JoseRicardoR/Resafeve/README.md

# Resafeve
Proyecto final de Sistemas Embebidos Universidad Nacional de Colombia

**Toda la información de este proyecto se encuentra en el repositorio de github: https://github.com/esteban11519/SistemasEmbebidos**

Integrantes del grupo:
*Mateo Bernal Bonil - Valentine Chimezie Muodum Prieto - Esteban Ladino Fajardo - Jose Ricardo Rincón Peláez*

Se quiere hacer un sistema de monitoreo en reservas naturales para reservas naturales, en el cual se instalan microfonos en arboles para el regustro de audio y su procesamiento con IA en un servidor aparte. Los micrfonos se controlan con ESP32, la comunicación se plantea por medio de MQTT al servidor Mosquitto situado en una Raspberry, conectada tambien a un servidor online.
En el siguiente esquema se ve la logica de funcionamiento, aunque en nuestro caso se hace uso de un servidor Mosquito, y el sensor es un microfono. Además si bien se pueden recibir mensajes con el ESP32 (y además se implemento dicha función) no fue necesario una aplicación que usara ese camino.

Esquema general

Luego, la inteligencia artificial usada se encuentra en: https://github.com/IBM/MAX-Audio-Classifier . Además la ESP32 deberá correr un sistema operativo en tiempo real para su mejor rendimiento, en este caso se usa FreeRTOS.

El proceso planteado es el siguiente:
* Registrar alrededor de 10 segundos en un arreglo de bytes en el ESP32.
* Enviar la señal en bytes desde el ESP32 hasta la raspberry por medio de mqtt.
* Luego en la raspberry convertir los datos en bytes en un archivo de audio .wav.
* Procesar con la IA el archivo de audio y obtener los resultados.
* Guardar los resultados en la en la base de datos InfluxDB.
* Finalmente mostrar los resultados en una pagina web para la toma de decisiones.

En cuanto a este repositorio, el archivo README es una documentación extensa y detallada de lo desarrollado, y se encuentran cuatro carpetas con las partes del proyecto. La carpeta de "DockerServices" contiene todas las aplicaciones de Docker además de las herramientas necesarias, la carpeta "ESP32" contiene todos los archivos relacionados con el microcontrolador, la carpeta "Front_end" la infromación relacionada a la pagina web y la carpeta "Prototipo" la información relacionada con el producto fisico en cuestion.

## Funcionalidad de la ESP32
En la carpeta del "SistemasEmbebidos/ESP32/EjemplosGuia/" se encuentran los siguientes archivos que sirven como base para realizar pruebas sencillas y entender el manejo de las herramientas usadas:
* freeRTOS.ino, que es un codigo desarrollado en arduino para la ESP32 en el que se ejemplifica el uso del FreeRTOS con multiples tareas.
* esp32_Multitasking.ino, que es otro ejemplo del uso de FreeRTOS pero aprovechando los dos cores del ESP32.
* mqtt_ESP32.ino, es un ejemplo de uso de MQTT en el ESP32 para muestrar datos, publicarlos, y recibir información. Como servidor de prueba se usa test.mosquitto.org, que es gratuito y disponible en internet para todo publico.
* I2C_Mic.ino, es el codigo de prueba más sencillo posible el microfono INMP441 con la interfaz I2S en el ESP32.
* python_mqtt_client.py, es un script de python sencillo que recibe y publica mensajes por medio de MQTT. Este fue modificado para que cuando acabara de generar en .wav lo enviara a la inteligencia artificial y publicara los resultados en el tópico cuyo inicio es *Embebidos/* los cuales se guardaban en la base de datos InfluxDB. En última instancia se le cambió el nombre a app.py y se ejecutó en un docker.

El microcontrolador usado en el proyecto es el ESP32 de referencia Wemos Loolin32. Este dispositivo cuenta con dos cores y la posibilidad de conectarse a internet. 

Pin out ESP32

Con el desarrollo del proyecto se evidenciaron y señalaron las limitaciones del dispositivo.

### PubSubClient
Para la comunicación se usa el protocolo de MQTT, que en el caso de la ESP32 se conecta con la librería PubSubClient, y para los demás elementos se usa la líbreria de python paho-mqtt. MQTT usa un sistema de subscripciones para la publiación de mensajes a tópicos específicos en el servidor.

Luego, unas primeras preguntas fueron ¿Cuantos segundos puede grabar el ESP32?¿De que tamaño es el Packete que se enviara?
De acuerdo a la documentación de pubsubclient el paquete máximo que se puede enviar son 256 bytes con la configuración. Es decir, hay un limite en el tamaño de paqute que se puede enviar, más en la propia documentación se explica que con la funcion client.setBufferSize(MQTT_MAX_PACKET_SIZE); se puede elegir el tamaño máximo del Buffer.
Luego la duda es por el lado de que tamaño es limite máximo que podemos tener. La cuestion es que entre más grande el paqute más se depende de la conexión a internet.

### Microfono electret
En primera instancia se probó para el muestreo de audio el uso de un micrófono electret con una configuración de amplifiación ya usada en otros proyectos. Luego el ESP32 en alguno de sus pines de lectura debería de ser capaz de muestrear la señal a la frecuencia deseada con el uso de un while y un delay. El archivo ESP32_Audio_mqtt_electret.ino en la carpeta del proyecto, se muestra el código en cuestion.

Cuando se implemento el codigo se encontró con el primer problema, la lectura de los pines del ESP32 no funcionaba. 
¿Por qué no funciona el AnalogRead en el código?
En cuanto al error de lectura del ESP32 cuando se usa el WiFi y MQTT el problema son que pines se eligen. Tal como indica la documentación y un foro, algunos Pines (como el 13 que se estaba usando) usan registros ADC2 que son los que manejan las funciones de WiFi de forma que si el WiFi esta activado quedan inhabilitados. Los pines que no se pueden usar son:  GPIO0, GPIO2, GPIO4, GPIO12 - GPIO15, GOIO25 - GPIO27. Luego de cambiar a los pines 34 para la lectura esta se hizo posible. 

Con el montaje inicial se desarrollo un script de python (en la carpeta SistemasEmbebidos/ESP32/Proyecto/python_mqtt_client_packages.py ) que recibia la información enviada del ESP32 y usaba multiples librerias. El proceso era:
* Se divide la información en el ESP32 en dos bytes por dato. La lectura es de 12 bits escalada a 16 bits. Pero el canal es de solo un byte de ancho. Además la inteligencia artificial pide idealmente un audio de 10s con una frecuencia de muestreo de 44100Hz y una resolución de 16 bits.
* En python se recibió esta información y con la funcion [numpy.frombuffer](https://numpy.org/doc/stable/reference/generated/numpy.frombuffer.html?highlight=frombuffer#numpy.frombuffer) se llega a la solución ya que retorna un arreglo unidimensional a partir de la señal de entrada 
* En el archivo python se usa luego la función numpy.concatenate para crear una [variable global](https://es.stackoverflow.com/questions/10768/crear-variables-globales-en-python) con toda la información recibida en todos los paquetes.  
* Finalmente se usan variables para contar los paquetes y datos y cuando se llega al punto deseado se usa https://docs.scipy.org/doc/scipy/reference/generated/scipy.io.wavfile.write.html#scipy.io.wavfile.write para crear el .wav

Este proceso funcionaba pero la calidad del sonido era mala y los tiempos de eran mucho más largos de lo esperado (enviar 9 segundos costaba casi minuto y medio). Una alternativa era usar las funciones beginplubish() y endpublish() de PubSubClient para que el proceso fuese más bien un stream de datos. Más sin embargo, estas dos funciones no enviaban toda la información por algún error desconocido. 

La solución inicial fue bajar la frecuencia de muestreo, de 44100Hz a 8000Hz. Antes de ello se probo en la inteligencia artificial que aún con audios de 8000Hz se obtuvieran resultados decentes. En comparación los resultados se muestran a continuación:
```
* 44100 Hz: {"status": "ok", "predictions": [{"label_id": "/m/01j4z9", "label": "Chainsaw", "probability": 0.6540094614028931}, {"label_id": "/m/04_sv", "label": "Motorcycle", "probability": 0.1308945119380951}, {"label_id": "/t/dd00066", "label": "Medium engine (mid frequency)", "probability": 0.12884050607681274}, {"label_id": "/m/0_ksk", "label": "Power tool", "probability": 0.11332365870475769}, {"label_id": "/m/07yv9", "label": "Vehicle", "probability": 0.10684427618980408}]}
```
```
* 8000 Hz: {"status": "ok", "predictions": [{"label_id": "/m/01j4z9", "label": "Chainsaw", "probability": 0.4117594063282013}, {"label_id": "/m/04_sv", "label": "Motorcycle", "probability": 0.206061452627182}, {"label_id": "/m/07yv9", "label": "Vehicle", "probability": 0.1337493658065796}, {"label_id": "/m/0_ksk", "label": "Power tool", "probability": 0.1071915328502655}, {"label_id": "/t/dd00066", "label": "Medium engine (mid frequency)", "probability": 0.07981646060943604}]}
```

Evidentemente con la frecuencia de muestreo mayor son mejores los resultados más con la frecuencia un poco más baja igual funciona.
Esto soluciono el problema del tiempo que ahora en total solo 16 segundos, es decir 2 segundos de envio por paquetes de 3 segundos. Paquetes mayores a 3 segundos con las condiciones descritas llenan la memoria. En términos generales se espera un tamaño de paquete alrededor de 48000 bytes. 
Por otro lado el problema de la calidad del audio seguia existiendo. Se probaron entonces mejores etapas de amplifiación como las mostradas en las imagenes.

Circuitos de amplificación señal de microfono electret

Pese a esto el montaje mostrado en la siguiente figura no tenia una buena calidad de sonido, además de tener una frecuencia de muestreo baja.
Montaje con amplificación y micrfono electret.



En todo caso no se consiguio que la señal de audio fuera mejor, ni añadiendo condensadores de desacople, en su mayoria es ruido como se ve en la siguiente imagen. Por ende el sonido no es legible.

Audio Con microfono electret

Se buscaron entonces alternativas y se encontro una de cambiar el sensor del proyecto.

### Microfono I2S INMP441
Tal parece que la conversión analoga digital del ESP32 consume mucho más CPU de la que se espera y hace que los procesos sean más demorados. Además si bien el circuito de amplificación está bien, se hace necesario el uso de un filtro para limpiar la señal. Se encontro que un micrófono Mems que usa la interfaz I2S se desarrollo para este tipo de proyectos. Su bloque funcional es como se ve a continuación.

INMP441

Luego como ya todo esta incorporado en este micrfono la labor consiste en configurar el software para su buen funcionamiento. Al incio se obtuvo un problema visible en la imagen a continuación. 

Audio con errores

El error consiste en que a veces el audio enviado no se graba correctamente, las muestras no se llenan por completo y hay muchos datos en 00. En consecuencia el audio suena entrecortado y “robótico”. Pese a las múltiples pruebas no he descubierto que genera estas inconsistencias, ni el tamaño ni cantidad de dma, ni los pines, ni el APLL-CLK, ni el tamaño de paquete ni audio total. Sencillamente, a veces funciona y a veces no.

Al revisar el montaje se encuentra que uno de los pines está mal conectado. Si se usa solo la señal mono izquierda es decir, .channel_format = I2S_CHANNEL_FMT_ONLY_LEFT,  se debe conectar el pin L/R a ground obligatoriamente. Dejarlo sin conectar como sugieren algunos tutoriales puede ocasionar el problema encontrado.

El montaje final es como se muestra a continuación. Muy sencillo.



El codigo completo se encuentra en la carpeta del proyecto con el nombre ESP32_I2S_Sampling.ino.
La señal de audio de salida es en definitiva clara y sin interrupciones. Se puede además muestrear a mayores frecuencias, se elige la de 16000Hz para no saturar de datos la red y la memoria del ESP32.



También se cambió el script de python para que ahora solo se requiera la libreria de Pahoo, así pues lo que se hace es generar un header al inicio del archivo que lo hace legible como .wav. Dicho header varia en relación a la frecuencia de muestreo, el numero de bits de resolución y el largo del archivo .wav.

El archivo definitivo tiene el nombre de ESP32_audio_receiver.py, y la explicación del header se puede encontrar en: http://soundfile.sapp.org/doc/WaveFormat/.

### FreeRTOS

En cuanto al componente FreeRTOS del proyecto, como se utiliza solo una función para todo el proceso en el ESP32, se procedio a hacer una tarea que contuviese todos estos elementos. En el archivo ESP32_I2S_Sampling.ino se ve como la tarea i2s_adc es instanciada como una task de FreeRTOS y este se reincia una vez cumple su ciclo. En una implementación donde se quisiese muestrear con dos microfonos al tiempo se podria crear una segunda tarea i2s_adc_2 con la misma funcionalidad. 

### Alimentación
Se analizaron dos alternativas para la alimentación de la ESP32 cuando se probase en campo. La primera y más sencilla es la alimentación de la tareta por medio de una pila de litio CR123 de 3.3V. En este caso se pudo realizar la prueba más parece para la aplicación dada se requiere una mayor potencia pues no fue suficiente para encender el montaje. Luego la segunda opción y mejor elaborada es el uso de paneles solares que carguen una pila de litio. Así será realmente independiente el diseño de estar conectado a una red electrica o de el recambio de baterias. El montaje es como se muestra a continuación y como documenta el proceso en https://randomnerdtutorials.com/power-esp32-esp8266-solar-panels-battery-level-monitoring/.

Alimentación ESP32 con paneles solares

En la carpeta "Prototipo" se muestran imagenes de la PCB con todos los componentes mencionados, así como un imagen 3D de como se vería el montaje completo.

## Funcionalidad de la FPGA

La tarjeta FPGA usada para este proyecto es la Blackice MX. Este dispositivo cuenta con la posibilidad de ser programado mediante un entorno grafico llamado
Icestudio mediante bloques que representan los modulos que normalmente se insatancian al ser usado un lenguaje de descripción de hardware convencional
(Verilog o VHDL).
Blackice II

### Tareas
La tarea principal a realizar por la FPGA en este proyecto consiste en la deteccion de audios validos que puedan ser analizados por medio de una inteligencia artificial,
esto con el fin de no saturarla con muchas peticiones procedentes de varios microfonos. Para que un audio se considere como válido, un porcentaje arbitrario de las
muestras que conforman una grabación (este porcentaje es determinado por el diseñador), deberá superar un umbral de intensidad (tambien establecido por el diseñador),
esto con el fin de determinar que el audio en efecto si puede contener información relevante y no es simplemente silencio o ruido intermitente.

Como ya se mencionó el ESP32 enviará la información referente a la Raspberry por medio de un servidor MQTT. Esta información será enviada a la FPGA por medio de un protocolo
de comunicacion serial (SPI), para su análisis y posterior devolución de resultados. En esta aplicación la Raspberry sera el denominado "Maestro" y la FPGA el "esclavo" debido
a como se realizan las solicitudes y quien es quien necesita enviar los comandos para la correcta operación del módulo.

Maestro_Esclavo

Para esta implementación se hara uso del bloque esclavo presente en una de las librerias de Icestudio.

Bloque_esclavo

Cada muestra de audio es representada por 2 Bytes de datos (16 bits), Sin embargo el bus de datos de este módulo es de 8 bits (que son recibidos serialmente desde el 
maestro y organizados en un registro propio del módulo). Por tanto se asignara 2 posiciones de memoria (2 registros de 8 bits mapeados en derterminadas direcciones de memoria),
a una muestra de audio en un instante. Para el envio de esta señal a la FPGA se cuenta con el bloque "SPI-cmd-regs" que se encargara de primero apuntar a la dirección de
alguno de los registros de la muestra instantanea y luego escribir el dato designado por el maestro, tambien es posible leer este dato en caso de que se requiera hacer alguna comparación (notese que se requerirá hacer dos veces este proceso para llenar totalmente los registros asignados a la muestra). 

### Control por SPI
SPI_Control_Mapeo

### Lectura de muestra


Arriba se puede ver el control de las posiciones de memoria de todos los registros asociados a la FPGA junto al diagrama que hace posible la concatenanción para la creación de
la muestra instantanea.

Una vez cargado el valor de la muestra instantanea, el maestro dará la orden de comparar la muestra con el valor de intensidad umbral previamente establecido, en caso tal de
que la muestra tome un valor mayor al establecido el contador se incrementara, esta orden de comparación tambien incrementara un registro donde se llevara la cuenta de cuantos
datos han sido comparados y por tanto el total de muestras validas que se han leido hasta el momento.

### Bloque de Comparación
Comparacion

### Bloque de Conteo de Muestras


El programa cuenta tambien con una funcion de reseteo universal de registros asignado a una posición de memoria en caso tal de que el maestro por alguna razon quiera abortar o 
reiniciar el proceso

En algunas imagenes se han mostrados bloques cuya unica funcion es leer constantes asociadas a posiciones de memoria especificas y retornar booleanos que son asignados a una variable de control en funcion a si esta constante coreesponde a la posicion de memoria seleccionada en una anterior transaccion, dichos bloques son los encargados de seleccionar el registro desde donde se seleccionara la información que sera enviada en la proxima transaccion de SPI desde el esclavo al maestro.

### Ejemplo de bloque de lectura de comparacion de identificacion de posicion de memoria



Para la lectura de registros se hace uso de un codificador 16-4 junto a un multiplexor 16-1 de 8 bits, la tarea del codificador es cifrar una la posiciones de memoria a la que se apuntó, de manera que este dato cifrado es reconocido como la linea desde la que el multiplexor deberá leer la información asociada a la posicion de memoria y por tanto enviarla por el pin MOSI. En caso de que ningun registro sea seleccionado para lectura, o de que se seleccione uno inexistente, la informacion enviada en la proxima transaccion al SPI será FF.

### Bloque de lectura de registros del esclavo


El mapa de memoria detallado obviando las posiciones asignadas a las instrucciones de apuntado, lectura y escritura se muestra a continuación.
### Mapa de Memoria del esclavo
<ul>
<li> hx01: M16_1  (Byte mas significativo de la muestra) </li>
<li> hx02: M16_2  (Byte menos significativo de la muestra) </li>
<li> hx03: Comparacion  (Emite un pulso que luego debera ser bajado a 0,
este pulso da la orden de comparar la muestra con el umbral y contabilizar) </li>
<li> hx04: U_Reset  (Resetea los contadores, hace la funcion de reset universal) </li>
<li> hx05: CriterioAud (Informa si las muestras que se han analizado superan  
el umbral de audio valido) </li>
<li> hx06: LCompleta (Informa si ya se ha hecho la lectura de todas las muestras) </li>
<li> hx07: Ndato1 (Recoge los 8 bits menos significativos de la cantidad total de 
datos que han sido leidos) </li>
<li> hx08: Ndato2 (Recoge los segundos 8 bits menos significativos de la cantidad
total de datos que han sido leidos) </li>
<li> hx09: Ndato3 (Recoge el bit mas signicado de la cuenta total de datos, este 
bit sera el menos significativo del arreglo de 8 bits que se envia) </li>
<li> hx0A: CUmbral1 (Recoge los 8 bits menos significativos de la cantidad total de 
muestras que han superado el umbral) </li>
<li> hx0B: CUmbral2 (Recoge los segundos 8 bits menos significativos de la cantidad
total de muestras que han superado el umbral) </li>
<li> hx0C: CUmbral3 (Recoge el bit mas significativo de la cantidad total de 
muestras que han superado el umbral,este bit sera el menos significativo del 
arreglo de 8 bits que se envia) </li>
</ul>

El diagrama total de la implementación de las funciones de comunicación (apuntado, lectura y escritura), y del esclavo (comparación, conteo, etc) se muestra a continuación.

### Diagrama de Implemantacion en la FPGA


Se adjunta a la documentación un archivo .ino haciendo las veces de maestro donde se puede verificar algunas de las funciones implementadas en la FPGA 
## Funcionalidad DockerServicios

Se encuentra implementado para la arquitectura ARMv7 y para AMD hasta antes de la integración total con el ESP32. En general los siquientes comandos se usan para ambas arquitecturas:

* Hacer una imagen (no olvidar estar en el directorio del Dockerfile y el punto al final):
```bash
sudo docker build -t <nombre_imagen>:tag . 
```
* Para montar servicios desde docker compose (se debe estar en el directorio del archivo *docker-compose.yml*):
```bash
sudo docker-compose up -d 
```

* Ver servicios montados:

```bash
sudo docker ps 
```

* Para reiniciar los servicios de docker compose (útil cuando se hace algún cambio en volúmenes y se debe estar en el mismo directorio del archivo docker-compose.yml).

```bash
sudo docker-compose restart 
```

* Para parar y eliminar los servicios de docker compose:
```bash
sudo docker-compose down 
```
* Para mirar las imágenes creadas:
```bash
sudo docker images
```

* Para eliminarlas:
```bash
sudo rmi <id/name>
```

Se eligió montar todos los servicios en contenedores docker dada la portabilidad.
### Servicios implementados en Docker

Se tomaron los mismos servicios que Sánchez [Sanchez] y las mismas configuraciones con algunas excepciones que se van a explicar.

#### Docker-compose

En el curso introductorio del youtuber [Pelado Nerd](https://www.youtube.com/watch?v=CV_Uf3Dq-EU) sobre docker se comenzó a montar contenedores desde comandos básicos hasta el punto de usar docker compose. Docke-compose hace parte de docker y su principal ventaja radica en organizar los volúmenes, las dependecias, los puertos y demás cosas en un archivo con el nombre *docker-compose.yml* de manera organizada. Sin embargo, la principal característica es que se crea por defecto una red entre los sevicios y el nombre de cada servicio tiene el alias de la ip de cada contenedor. Por ejemplo, en la siguiente sección de *docker-compose.yml* el Broker MQTT tiene la ip en el alias *mosquitto*.

```yml
services:
    mosquitto:
        image: eclipse-mosquitto:2.0.10
```

Esto es necesario dado que los contenedores pueden cambiar la ip y no se hace práctico en un proyecto dado que generaría fallas de comunicación.
#### Broker MQTT

Para este servicio se eligió mosquitto y esta es su configuración en docker compose:
```yml
mosquitto:
        image: eclipse-mosquitto:2.0.10
        restart: always
        ports: 
            - 1883:1883  
        volumes:
            - ./BaseDatos/mosquitto/config:/mosquitto/config
            - ./BaseDatos/mosquitto/data:/mosquitto/data
            - ./BaseDatos/mosquitto/log:/mosquitto/log
    
```

 1. image: eclipse-mosquitto:2.0.10
 
  Se elige una imagen de [Docker Hub](https://hub.docker.com/_/eclipse-mosquitto) con el tag 2.0.10 y se verifica que esté disponible para la arquitectura deseada que en este caso es AMD y ARMv7. 

2. restart: always

Esto permite que funcione cada vez que se prende el dispositivo que lo contiene o cada vez que tenga un error.

3.  
```yml
        ports: 
            - 1883:1883 
```

Se mapea el puerto interno del docker :1883 al puerto externo del dispositivo 1883:.

4. Volumes: el único que en realidad es importante es la configuración que hay en el archivo mosquitto.config y que se coloca en el directorio local ./BaseDatos/mosquitto/config que se va reflejar en el archivo con el mismo nombre dentro de la dirección del contenedor /mosquitto/config. Esto permite que cada vez que se reinicialice el docker se mantenga la misma configuración. El contenido de dicho archivo es:

```
listener 1883 0.0.0.0
allow_anonymous true
```
Recomentaciones:
- Debe recordarse que toda información que se coloque en un docker se va a eliminar una vez se reinicialice y por ende se deben colocar volúmenes para que esta sea persistente. Un error que se tuvo fue el pensar que si se configuraba el archivo desde el interior del contenedor el cambio en el volumen se iba a ver de manera local en el reinicio pero en realidad sucede lo contrario.

#### InfluxDB

Se escoge una base de datos de serie temporal dada la naturaleza del proyecto.

```yml
influxdb:
        image: influxdb:1.8
        restart: always
        ports: 
            - 8086:8086
        volumes: 
            - ./BaseDatos/influxdb_data:/var/lib/influxdb
        environment: 
            - INFLUXDB_DB=embebidos
            - INFLUXDB_ADMIN_USER=admin
            - INFLUXDB_ADMIN_PASSWORD=admin
            - INFLUXDB_HTTP_AUTH_ENABLED=true
```
1. ```image: influxdb:1.8```

Se elige la imagen *influxdb* con el tag *1.8* y se verifica en [Docker Hub](https://hub.docker.com/_/influxdb) la compatibilidad de arquitecuras. Se eligió otro tag con el objetivo de usar uno más actualizado pero se encontró que no se podía acceder a ella con el método que decía Sánchez y que se expone a continuación:

Para acceder al interior del contenedor InfluxDB se hace así:
```bash
sudo docker exec -it <id/nombre contenedor InfluxDB> bash
```
Registrarse con el usuario y contraseñas

```bash
influx -username <usuario> -password <contraseña>
```

Observar las bases de datos creadas
```bash
show databases
```
Usar una base de datos:

```bash
use <base de datos>
```
Mirar las distintas 'tablas' creadas:
```bash
show measurements
```

Observar todos los resultados de la tablas:
```bash
select * from <tabla>
```
Esto fue de ayuda para verificar que se estaban guardando los datos de manera correcta cuando no se tenía una interfaz gráfica. 

2. 
```yml
 ports: 
            - 8086:8086
```
Se mapeo el puerto :8086 del contenedor al puerto 8086: del dispositivo local.

3. 
```yml
        volumes: 
            - ./BaseDatos/influxdb_data:/var/lib/influxdb
```
Se guarda la información de la base de datos dentro de la ruta /var/lib/influxdb que está en el contenedor a la ruta local ./BaseDatos/influxdb_data. En este caso es como si hubiera un enlace simbólico del interior del contenedor al directorio local.

4. 
```yml
        environment: 
            - INFLUXDB_DB=embebidos
            - INFLUXDB_ADMIN_USER=admin
            - INFLUXDB_ADMIN_PASSWORD=admin
            - INFLUXDB_HTTP_AUTH_ENABLED=true
```
Se expecifica por medio de variables de entorno propios de esta imagen que la base de datos se llama *embebidos* (INFLUXDB_DB=embebidos), se coloca como usuario y contraseña *admin* (INFLUXDB_ADMIN_USER=admin, INFLUXDB_ADMIN_PASSWORD=admin) y se habilita la comunicación HTTP (INFLUXDB_HTTP_AUTH_ENABLED=true).

#### telegraf

Con este servicio se busca enviar toda la información publicada en un tópico configurado a la base de datos influxdB
```yml
telegraf: 
        image: telegraf:1.18.3
        restart: always
        volumes:
            - ./BaseDatos/telegraf/telegraf.conf:/etc/telegraf/telegraf.conf
        depends_on: 
            - influxdb
    
```
1. ```image: telegraf:1.18.3```: Se busca en [docker hub](https://hub.docker.com/_/telegraf) la imagen compatible con las arquitecturas.

2. 
```yml
volumes:
            - ./BaseDatos/telegraf/telegraf.conf:/etc/telegraf/telegraf.conf
```
El archivo de la ruta local ./BaseDatos/telegraf/telegraf.conf se vincula con el archivo dentro del contenedor /etc/telegraf/telegraf.conf y este es su contenido fundamental (lo que no significa la falta de la demás configuración):

```
[[outputs.influxdb]]
urls = ["http://influxdb:8086"]
database = "embebidos"
skip_database_creation = true
username = "admin"
password = "admin"
```
* La ip de la base de datos y el puerto está representado por http://influxdb:8086 que corresponde al alias de la base de datos InfluxDB y el puerto interno 8086 del contenedor.
* Se especifica que la base de datos que se va a usar es *embebidos* que debe coincidir con la creada en InfluxDB.
* No se crea nueva base de datos de datos.
* Se le coloca el mismo usuario y contraseña usados en las variables de entorno de InfluxDB.

```
[[inputs.mqtt_consumer]]
 servers = ["tcp://mosquitto:1883"]
 topics = ["Embebidos/#"]
     name_override = "embebidos"

    json_string_fields = [
      "predictions_0_probability",
      "predictions_1_probability",
      "predictions_2_probability",
      "predictions_3_probability",
      "predictions_4_probability"
      ]
      
    tag_keys = [
      "predictions_0_label",
      "predictions_1_label",
      "predictions_2_label",
      "predictions_3_label",
      "predictions_4_label"
      ]
    data_format = "json"
```

* Se especifica el protocolo de comunicación TCP, la dirección ip *mosquitto* y el puerto (1883) correspondientes al Broker MQTT.

* Se va a guardar en la base de datos influxDB la información que se publique en el tópico *Embebidos/#*
* Se especifica el nombre de la "tabla" (embebidos) en el que se va a guardar la información.
* Dada la estructura del json que se expuso anteriormente se escoge la información que se va a guardar que en este caso es el label y la probabilidad de ocurrencia asociada con dicho label.
* Finalmente se especifica que se va a guardar como un json (Se hace distinto que Sánchez [Sanchez].

Este último tema fue el que más causó dificultades dado que solo se estaban guardando las probabilidades más no los labels asociados. Para esto se buscó en la documentación de telegraf con respecto a los [tipos de datos json](https://github.com/influxdata/telegraf/tree/master/plugins/parsers/json) y se implementaron. Se notó que telegraf solo guarda datos que tengan la estructura configurada, esto generó un problema de comprobación en donde se enviaban datos con estructuras distintas y no se guardaban.

3.  
```yml
depends_on: 
            - influxdb
```
Se espera hasta que el servicio con nombre influxdb se haya creado para este hacerlo. Esto ayuda a que la base de datos de la configuración ya se haya creado.

#### grafana

Para realizar gráficos con respecto a la información que se tenga en la base de datos InfluxDB se usa Grafana. 
```yml
grafana: 
        image: grafana/grafana:7.5.7 
        restart: always
        ports:
            - 3000:3000 
        volumes:
            - grafana-storage:/var/lib/grafana  
        depends_on: 
            - influxdb
    
```

1. ```image: grafana/grafana:7.5.7```

Se busca una imagen compatible con las arquitecturas que se tienen en [Docker Hub](https://hub.docker.com/r/grafana/grafana)

2. 
```yml
        ports:
            - 3000:3000 
```
Se mapea el puerto :3000 del contenedor al puerto 3000: del dispositivo local.

3. 
```yml
volumes:
    - grafana-storage:/var/lib/grafana  
```

Se guarda de manera local en el volumen *grafana-storage* la configuración hecha en el contenedor para graficar los datos que se localiza en su ruta /var/lib/grafana.

4. 
```yml
volumes:
    grafana-storage:
        external: false
```
Se tuvo que crear un volumen *especial* para grafana porque fue la única forma que se encontró para que no se borraran los cambios editados en su interfaz después de varios intentos mediante la forma convencional con la que se venía haciendo.

#### ser_brokerconection

Este fue el servicio que se creo de manera local y cuya estructura varía un poco con respecto a las que se se expusieron. Su función principal es ejecutar de manera automática y continua el script ```app.py```.
```yml
    ser_brokerconection:
        build: ./BrokerMqttPython/BrokerConection
        restart: always
        depends_on:
            - mosquitto
```
1. build: ./BrokerMqttPython/BrokerConection

En la dirección relativa *./BrokerMqttPython/BrokerConection* al archivo docker-compose.yml se tiene una archivo Dockerfile que crea una imagen con la siguiente descripción:

```Dockerfile
FROM python:3.7.3

WORKDIR /usr/src/app

COPY requirements.txt ./
RUN pip install --no-cache-dir -r requirements.txt
RUN apt update && apt install -y curl && apt install -y avahi-daemon

COPY . .

CMD ["python3", "./app.py" ]
```
a.  ```FROM python:3.7.3```

Se descarga de Docker Hub la imagen python:3.7.3 que corresponde a la misma versión con el que se comprobó el correcto funcionamiento del script *app.py* en la raspberry.

b. ```WORKDIR /usr/src/app```

Establece el directorio de trabajo como /usr/src/app según la documentación de [Docker Hub](https://hub.docker.com/_/python). Esto significa que los cuando se increse al contenedor por medio de bash o cuando se copia (por comando del Dockerfile) algo dentro del contenedor se va a realizar en esta dirección.

c. ```COPY requirements.txt ./```

Copia el archivo requirements.txt que contiene las librería necesarias para el script *app.py* y que se encuentra en la misma dirección del archivo *Dockerfile* en el directorio de trabajo dentro del contedor.

d. ```RUN pip install --no-cache-dir -r requirements.txt```

Se instalan las librerías que están en requirements.txt.

e. ```RUN apt update && apt install -y curl && apt install -y avahi-daemon```

Se instala curl y avahi-daemon necesarios para el funcionamiento de *app.py*. Sin embargo, avahi-daemon no reconoció la ip de un dispositivo externo al que contenía el docker. Dada esta irregularidad se tuvo que colocar la ip numérica del dispositivo en el que se tiene el servicio de la IA.

f. ```COPY . .```

Se copia todo lo que hay en el directorio actual dentro del directorio de trabajo del Docker (excepto lo que está en .dockerignore).

e. ```CMD ["python3", "./app.py" ]```

Se ejecuta dentro del contenedor el comando ```python3 app.py``` por defecto.

2.  ```restart: always```

Se reinicia siempre y se crea después del servicio moquitto.

#### docker-compose final 

Uniendo todos los servicios en un docker-compose.yml se tiene el siquiente archivo:

```yml
version: '3.1'

services:
    mosquitto:
        image: eclipse-mosquitto:2.0.10
        restart: always
        ports: 
            - 1883:1883  
        volumes:
            - ./BaseDatos/mosquitto/config:/mosquitto/config
            - ./BaseDatos/mosquitto/data:/mosquitto/data
            - ./BaseDatos/mosquitto/log:/mosquitto/log
    
    telegraf: 
        image: telegraf:1.18.3
        restart: always
        volumes:
            - ./BaseDatos/telegraf/telegraf.conf:/etc/telegraf/telegraf.conf
        depends_on: 
            - influxdb

    influxdb:
        image: influxdb:1.8
        restart: always
        ports: 
            - 8086:8086
        volumes: 
            - ./BaseDatos/influxdb_data:/var/lib/influxdb
        environment: 
            - INFLUXDB_DB=embebidos
            - INFLUXDB_ADMIN_USER=admin
            - INFLUXDB_ADMIN_PASSWORD=admin
            - INFLUXDB_HTTP_AUTH_ENABLED=true
            
    grafana: 
        image: grafana/grafana:7.5.7 
        restart: always
        ports:
            - 3000:3000 
        volumes:
            - grafana-storage:/var/lib/grafana  
        depends_on: 
            - influxdb
           
    ser_brokerconection:
        build: ./BrokerMqttPython/BrokerConection
        restart: always
        depends_on:
            - mosquitto

volumes:
    grafana-storage:
        external: false
```
#### Inteligencia Artificial

La [inteligencia artificial](https://www.google.com/url?q=https://github.com/IBM/MAX-Audio-Classifier) se tiene implementada en una arquitectura AMD y puede reconocer los sonidos de este [archivo](./docs/class_labels_indices.csv) entre los cuales se encuentra motosierra, motor, vehículo, motocicleta y entre otros. Se obtienen 5 resultados numerados del 0 al 4 con sus repectivas probabilidades. Con el siguiente comando se obtienen de manera local los resultados:

```bash
curl -F "audio=@<dirección y extensión del audio>;type=audio/wav" -XPOST <Ip y puerto de la IA>/model/predict
```
Esta información se almacena en un archivo y se envía a la base de datos por medio del script app.py implementado en Docker.

#### Recomendaciones

La ip del servidor que contenga la IA se debe modificar en el archivo app.py y luego ejecutar el archivo docker-compose para la arquitectura arm.
## FRONT END
Para el front end (Interfaz Hombre Maquina) se realizó una página web que hace uso de lenguaje HTML, JAVASCRIPT, NODE.js, CSS y PYTHON para su funcionamiento como diseño. Particularmente NODE.js y PYTHON se uso para parte del backend que principalmente es la lectura de la base de datos InfluxDB. Para hacer una descripción de cada parte de la página clara y concisa se dividió la página en "Encabezado" y "Main".

### ENCABEZADO
Para el encabezado se siguió la siguiente maqueta de HTML.
```html
nav class="navbar">
        <div class="navbar_container">
            <a href="/" class="" id="navbar_logo"><i class="fab fa-pagelines"></i>Resafeve</a>
        </div>
        <div class="navbar_containerlinks">
            <ul class="navbar_menu">
                <li class="navbar_items">
                    <a href="https://github.com/esteban11519/SistemasEmbebidos" class="navbar_links">Documentacion</a>
                </li>
                <li class="navbar_items">
                    <a href="/" class="navbar_links">Equipo</a>
                </li>
                <li class="navbar_button">
                    <a href="http://192.168.1.86:3000/d/MZVyWBmRk/embebidos?from=1629944777057&to=1630549577057&orgId=1" class="button">Monitorear</a>
                </li>
            </ul>
        </div>
    </nav>
```

En el anterior código vemos varios elementos \<a> que hacen referencia a los "Links" a otras páginas. Para este caso tenemos los siguientes botones. 
  
Screenshot from 2021-09-02 09-09-01
        
Que como vemos en la maqueta de HTML al presionar "Documentacion" nos redirecciona al GitHub del proyecto mientras que al presionar Monitorear nos direcciona a Grafana a un Dashboard. Además de estos elementos tenemos los títulos de la página que tiene un estilo particular ya que se le agrego un degrade en la hoja de estilos. Además para el "icono" se uso un script prestado por la página https://fontawesome.com/, donde al registrarse y poner la etiqueta del script que nos dan para nuestra cuenta ya con solo hacer referencia a la clase "fab fa-pagelines" de la imagen esta aparece en el elemento deseado.
       
Screenshot from 2021-09-02 09-33-40
 
```css 
 #navbar_logo {
    background-color: #0a8124;
    background-image: linear-gradient(to bottom, #19e946 0%, #00a524 100%);
    background-size: 100%;
    -webkit-background-clip: text;
    -moz-background-clip: text;
    -webkit-text-fill-color: transparent;
    -moz-text-fill-color: transparent;
    display: flex;
    cursor: pointer;
    text-decoration: none;
    font-size: 2rem;
} 
        
```
Hay algunos otros elementos y utilidades de CSS que son interensantes, como el HOVER que nos permite interactuar con los elementos, como ponerlos opacos o cambiarlos de color. Esto hace la experiencia de usuario mucho mas amena.
        
### MAIN
        
Para el main se uso un contenedor que cotiene una imagen con una frase y adicionalmente tiene algunos widgets para la visualización de la información obtenida a su vez con la base de datos. Para el primer widget se uso programó un reloj con fecha mediate el usod de variables propias de javascript Date() y mediante a una iteración se actuliza la fecha y la hora por cada intérvalo de tiempo. Adicionalmente se programó un indicador de alarma basado en la última lectura de la base de datos y algunos criterios que se especificarán posteriormente. Este widget cambiará su color y su texto dependiendo del dato almacenado por el análisis de la inteligencia artificial.

 Screenshot from 2021-09-02 09-44-24
        
 Ahora este Widget resume todo el funcionamiento principal del backend. Primero tenemos una aplicacion de Python la cual cuenta con la libreria mas importante para la lectura de datos desde la base de datos influxDB (INFLUXDB). Esta libreria nos permite crear un cliente y  conectarnos a la base de datos, para posteriormente usar la funcion .query para hacer solicitudes tipo "SQL". 

```py 
        client = influxdb.InfluxDBClient(host='192.168.1.86', port=8086, ....)
        Lecturas_2 = client.query(f"SELECT * FROM embebidos WHERE time > now()-14d")
```
De esta manera se crea un archivo json que posteriomente nos permite usar Node.js junto con algunos paquetes como  EXPRESS, CORS y FS. Estas librerías primero como EXPRESS sirven para montar servicios para hacer solicitudes APIS , CORS soluciona un problema de comunicación entre HTTPS y HTTP. Además, FS nos ayuda a leer los json. Finalmente con ayuda de FETCH se hace la solicitud desde la pagina web y mediante el metodo .then() podemos enviar los resultados retornados por FETCH a alguna función para de esta manera analizar y modificar el widget en cuestión.
 
```py 
     fetch('http://localhost:1500')
    .then(response => response.json())
    .then(data => printIt(data));
```

## Bibliografia
Recursos adicionales
* MQTT - Resumen de todo con explicaciones y links de temas relacionados: https://aprendiendoarduino.wordpress.com/2018/11/19/mqtt/ 
* Esp32 Mqtt explicado: https://randomnerdtutorials.com/esp32-mqtt-publish-subscribe-arduino-ide/
* Inteligencia Artificial que clasifica los sonidos: https://www.google.com/url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 
* Documentacion Espressif del ESP32: https://docs.espressif.com/projects/esp-idf/en/latest/esp32/index.html
* Datasheet del Microfono INMP441: https://www.google.com/url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
*  Documentacion SPI y Icestudio: https://github.com/Obijuan/Cuadernos-tecnicos-FPGAs-libres/wiki/CT.5:-SPI-esclavo

* [Sanchez] J. J. Sánchez Hernández, «IoT Dashboard - Sensores, MQTT, Telegraf, InfluxDB y Grafana». may 20, 2021. [En línea]. Disponible en: http://josejuansanchez.org/iot-dashboard/

* «Docker Hub». https://hub.docker.com/ (accedido sep. 02, 2021).
Pelado Nerd, DOCKER 2021 - De NOVATO a PRO! (CURSO COMPLETO), (2021). Accedido: sep. 02, 2021. [En línea Video]. Disponible en: https://www.youtube.com/watch?v=CV_Uf3Dq-EU
