JoseRicardoR/Resafeve/DockerServices/amd/BrokerMqttPython/BrokerConection/referencias.md

https://lindevs.com/install-curl-on-raspberry-pi/
https://zoomadmin.com/HowToInstall/UbuntuPackage/avahi-daemon
https://gnanesh.me/avahi-docker-non-root.html
