JoseRicardoR/Resafeve/Prototipo/Prototipo dispositivo Resafeve.pdf

TÍTULO | Prototipo dispositivo Resafeve N.º DE PIEZA REVISIÓN DISEÑADOR INGENIERO NOTAS

LA INFORMACIÓN O LOS MATERIALES DE ESTE DOCUMENTO SON PROPIEDAD E INFORMACIÓN RESTRINGIDA O MATERIALES DEL AUTOR. ESTA INFORMACIÓN NO SE PUEDE UTILIZAR, REPRODUCIR, PUBLICAR O REVELAR A TERCEROS SIN AUTORIZACIÓN POR ESCRITO. DEBE UTILIZARSE SOLO PARA LA FABRICACIÓN DE LOS ELEMENTOS ESPECIFICADOS EN EL DOCUMENTO.
