JoseRicardoR/Resafeve/DockerServices/amd/BrokerMqttPython/referencias.md

Para el código fuente : http://www.steves-internet-guide.com/into-mqtt-python-client/
Para complementarlo y entenderlo.

Bloque de lectura: E. Matthes, «Python Crash Course», en Files and Exceptions, 2.ª ed., San Francisco, 2019, p. 198.

Para el os.system de procesamiento: https://www.programaenlinea.net/ejecuta-comandos-unix-python/

Para cadenas f:https://python-para-impacientes.blogspot.com/2017/02/las-cadenas-f.html

while True: https://es.stackoverflow.com/questions/142679/c%C3%B3mo-funciona-un-bucle-while-true

Para entender la estructura de dockerfile
https://docs.docker.com/engine/reference/builder/

Renombrar archivos en python
https://decodigo.com/python-renombrar-un-archivo

Guardar string en la base de datos

https://github.com/influxdata/telegraf/issues/7536
