JoseRicardoR/Resafeve/Prototipo/EsquemaPrototipo.PNG

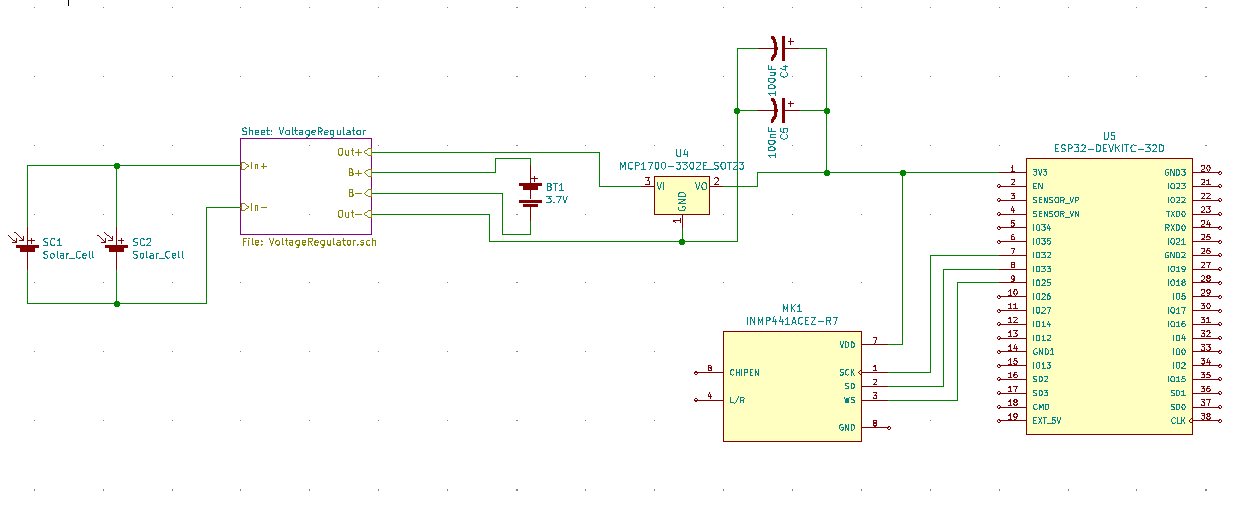
Prototipo/EsquemaPrototipo.PNG
