JoseRicardoR/Resafeve/Prototipo/PCB3d.PNG

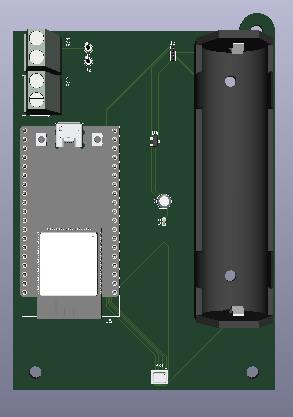
Prototipo/PCB3d.PNG
