JoseRicardoR/Resafeve/Prototipo/PCB.PNG

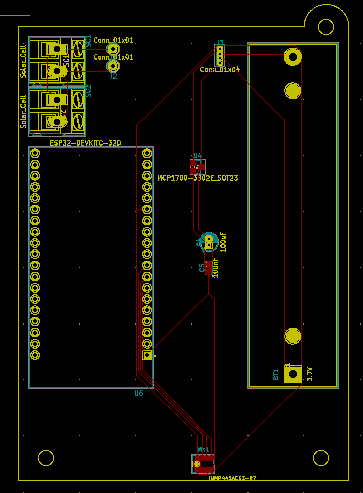
Prototipo/PCB.PNG
