JoseRicardoR/Resafeve/Prototipo/ProptotipoCompleto.PNG

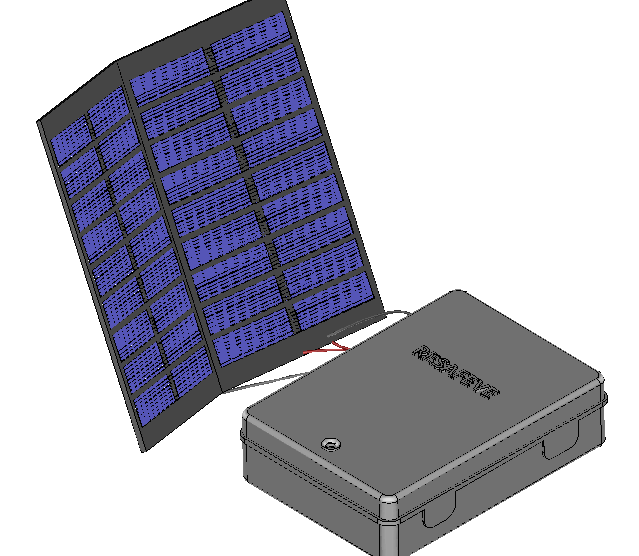
Prototipo/ProptotipoCompleto.PNG
