JoseRicardoR/Resafeve/Prototipo/Prototipo PCB.kicad_pcb

## KiCad design Prototipo/Prototipo PCB.kicad_pcb (2021-09-06)

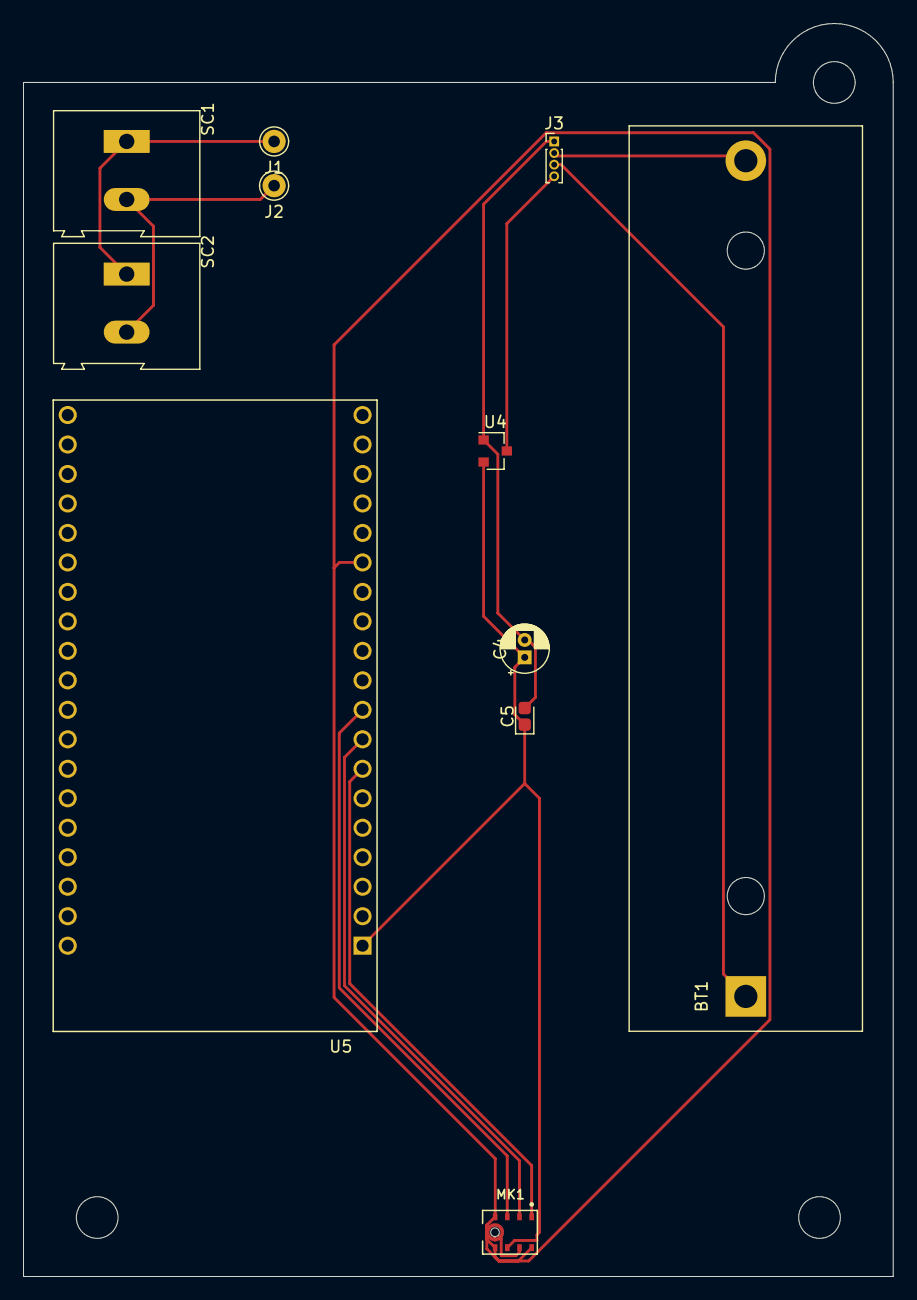
[picture p5: board Prototipo PCB.kicad_pcb from above]

Board: 2 copper layers, 74.9 x 108.0 mm, 11 parts (0 on the bottom side), 11 nets.

Parts:
BT1: 3.7V; BatteryHolder_MPD_BH-18650-PC2
C4: 100uF; CP_Radial_D4.0mm_P1.50mm
C5: 100nF; CP_EIA-1608-08_AVX-J
J1, J2: Conn_01x01; Pin_D1.0mm_L10.0mm
J3: Conn_01x04; PinHeader_1x04_P1.00mm_Vertical
MK1: INMP441ACEZ-R7; MIC_INMP441ACEZ-R7
SC1, SC2: Solar_Cell; TerminalBlock_Altech_AK300-2_P5.00mm
U4: MCP1700-3302E_SOT23; SOT-23
U5: ESP32-DEVKITC-32D; MODULE_ESP32-DEVKITC-32D

Connections:
unnamed: BT1.1, J3.3
unnamed: BT1.2, J3.2
unnamed: C4.1, C5.1, MK1.7, U4.2, U5.1
unnamed: C4.2, C5.2, J3.1, U4.1
unnamed: J1.1, SC1.1, SC2.1
unnamed: J2.1, SC1.2, SC2.2
unnamed: J3.4, U4.3
unnamed: MK1.1, U5.7
unnamed: MK1.2, U5.8
unnamed: MK1.3, U5.9
unnamed: MK1.4, MK1.5, MK1.6, MK1.9, U5.14
