JoseRicardoR/Resafeve/(commit log)

2021-05-13 Base de datos lista en linuz con conexión a python
    [pyvenv.cfg]
2021-05-15 Update esp32_Multitasking.ino
    Ejemplo de Multitasking y Multicore en el ESP32 con FreeRTOS
2021-05-27 Funciona la base de datos, el administrador phpmyadmin y la aplicación para buscar en la base de datos. Aparece el error del puerto 5000 ocupado
2021-05-29 Funciona la aplicación de manera automáttica
2021-05-31 Se implementó la base de datos con el servidor mosquitto
2021-06-01 Base de datos implementada con grafana
2021-06-04 Se publican en un broker-mqtt los resultados de la inteligencia artificial
    [pyvenv.cfg]
2021-06-14 se puso la base de datos en términos de variables de entorno
2021-06-17 Update mqtt_ESP32.ino
    el envio de datos ya es el correcto
    [mqtt_ESP32.ino]
2021-06-17 Add files via upload
    Cliente de python que se conecta con el ESP32, recibe sus datos y crea el .wav
2021-08-15 Dos Docker pueden acceder a una misma carpeta
    [pyvenv.cfg]
2021-08-23 Se mejoraron los scripts de las bases de datos
2021-08-23 Base de datos arm
2021-08-24 Add files via upload
    Archivo de python que recibe señal del ESP32 y la convierte en .wav
2021-08-26 BrockerMqttPython en arm y telegraf guarda en string
    [pyvenv.cfg]
2021-08-27 Organización
    [pyvenv.cfg]
2021-08-27 configuración raspberry con aplicación paho.mqtt en docker
2021-08-29 Archivo funcional, para siempre de mqtt python
    Este archivo recibe los datos enviados por el ESP32 y los escribe en un .wav de nombre Audio, luego da 20 segundos despeus de recibir el ultimo paquete de datos para enviar o mover el archivo. Pasado ese tiempo se borra el archivo y reescribe con los datos nuevos que lleguen del ESP32
2021-08-29 Archivo que corre el ESP32
2021-08-31 Update ESP32_audio_reciever.py
    Se agregaron los casos de error
    [ESP32_audio_reciever.py]
2021-09-01 Update and rename I2S_Sampling.ino to ESP32_I2S_Sampling.ino
2021-09-02 Prueba ESP32
2021-09-02 Update README.md
    Primera parte de Front-End
2021-09-02 Update README.md
    Actualizacion de Front End
2021-09-02 Cambios raspberry
2021-09-03 Modificación git
    [class_labels_indices.csv]
2021-09-04 Add files via upload
    Docs
    [class_labels_indices.csv]
2021-09-05 Docker en arm de servicio web. Modificar index.js y app_1.js para docker
2021-09-05 cambio desde raspberry
2021-09-06 Funciona desde arm
